Cyb3rn0id/Pellet-Stove-Web-Control/documents/schematic.jpg

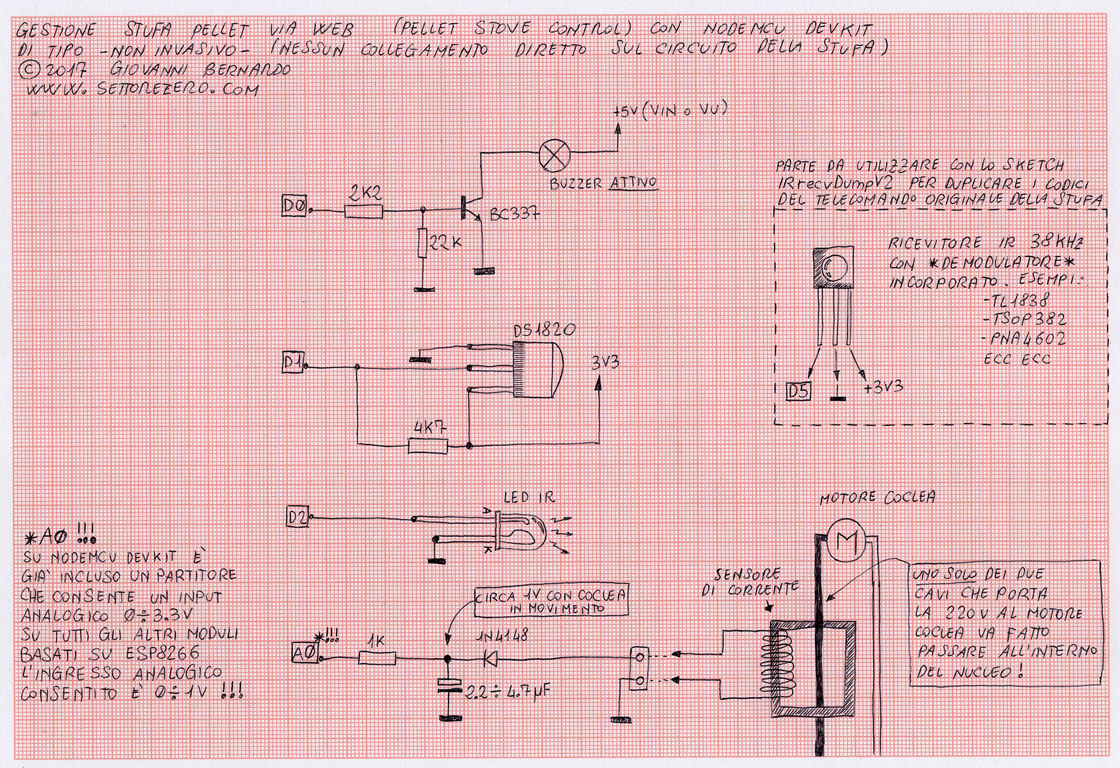
documents/schematic.jpg
