Cyb3rn0id/Pellet-Stove-Web-Control/images/current_sensor_1.jpg

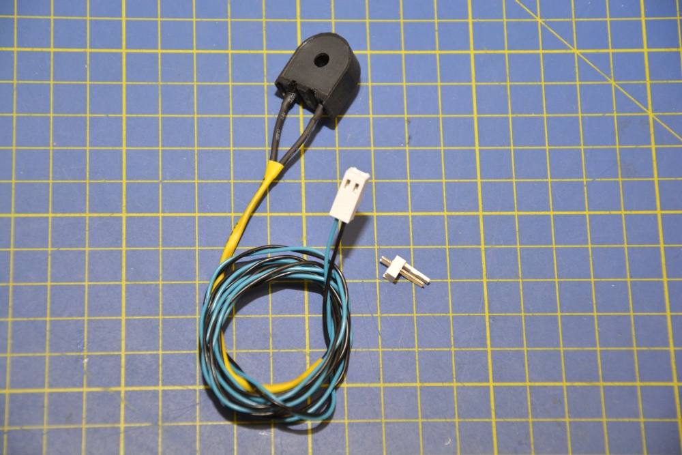
images/current_sensor_1.jpg
