Cyb3rn0id/Pellet-Stove-Web-Control/images/current_sensor_3.jpg

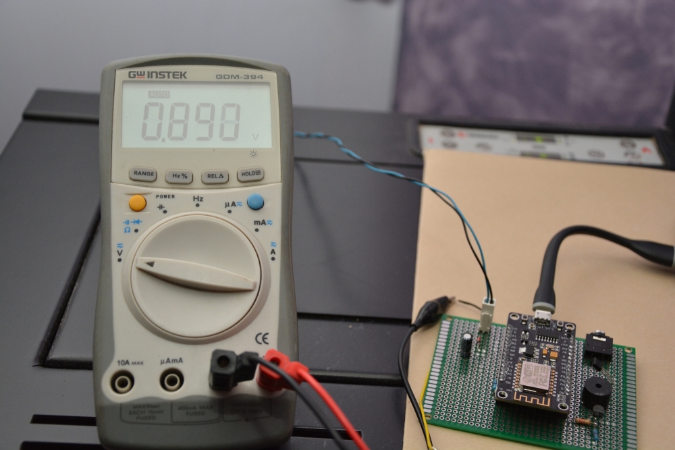
images/current_sensor_3.jpg
