Cyb3rn0id/Pellet-Stove-Web-Control/images/current_sensor_4.png

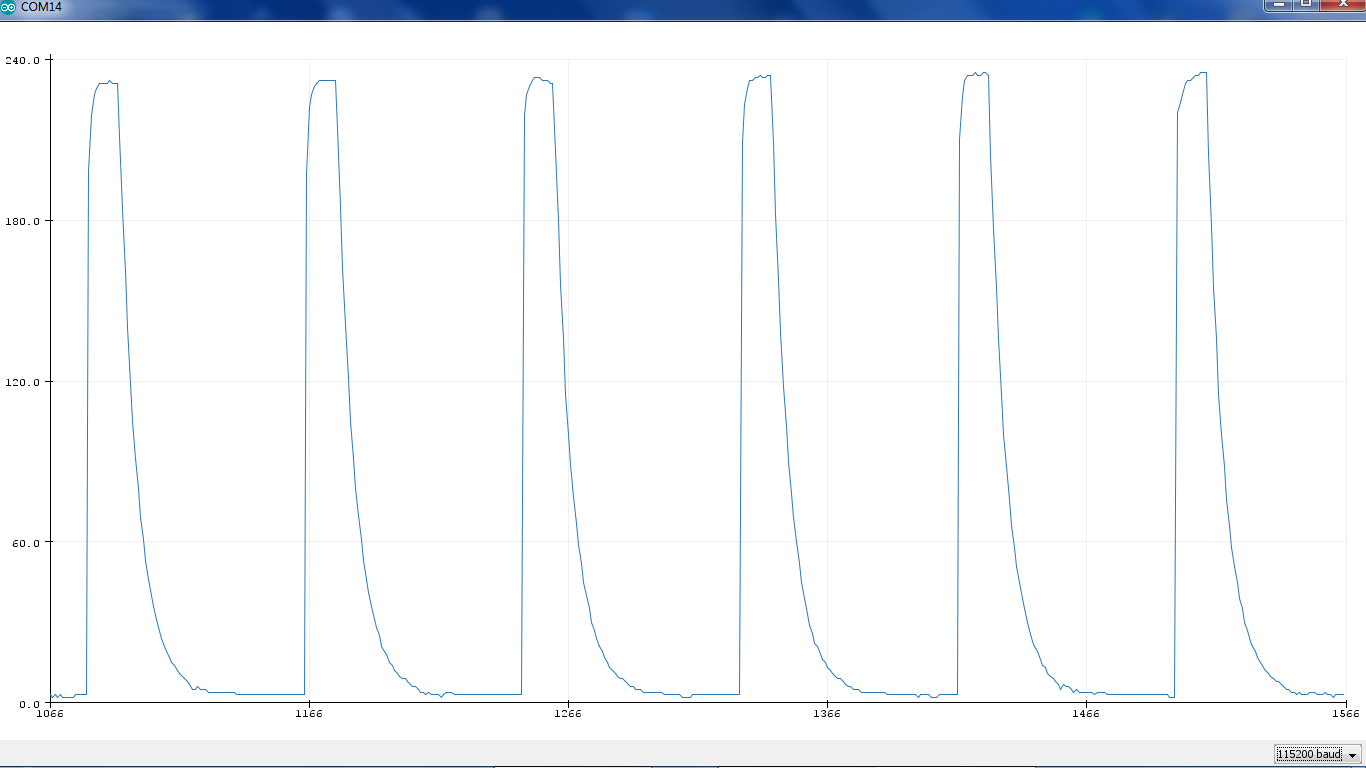
images/current_sensor_4.png
