Cyb3rn0id/Pellet-Stove-Web-Control/images/pic_01.jpg

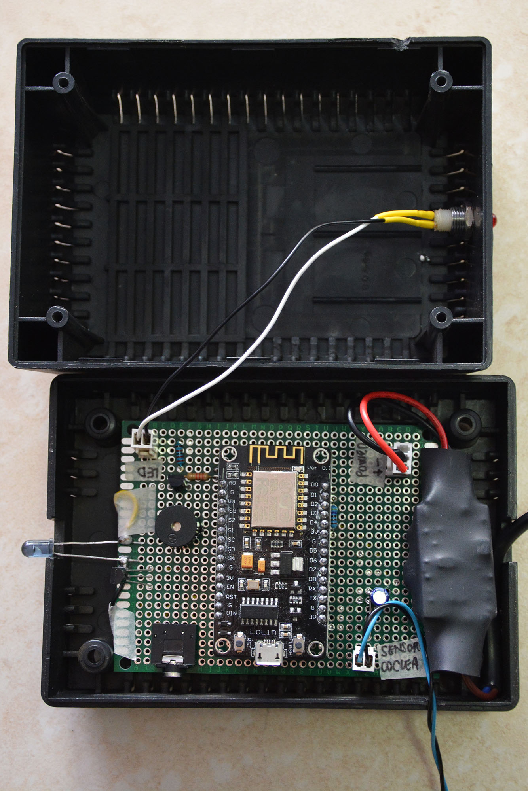
images/pic_01.jpg
