Cyb3rn0id/Pellet-Stove-Web-Control/images/pic_02.jpg

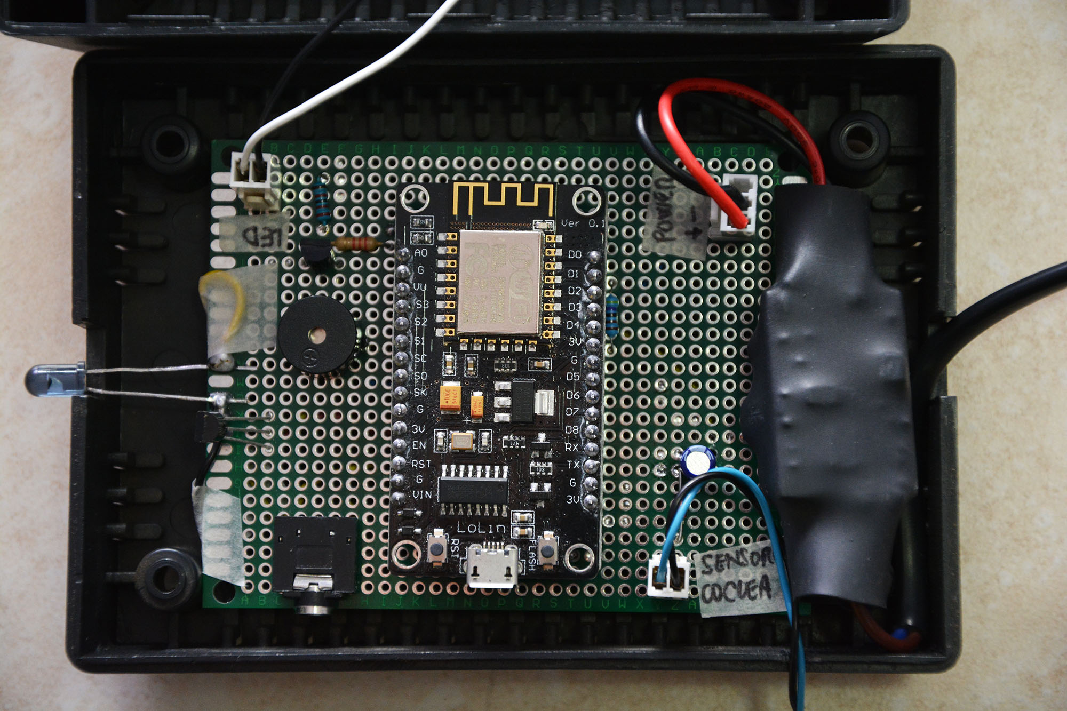
images/pic_02.jpg
