Cyb3rn0id/Pellet-Stove-Web-Control/images/pic_03.jpg

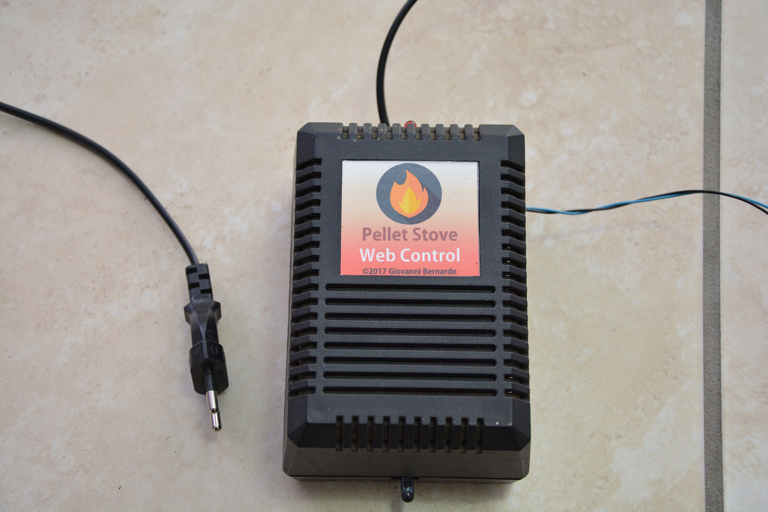
images/pic_03.jpg
