Cyb3rn0id/Pellet-Stove-Web-Control/images/pic_04.jpg

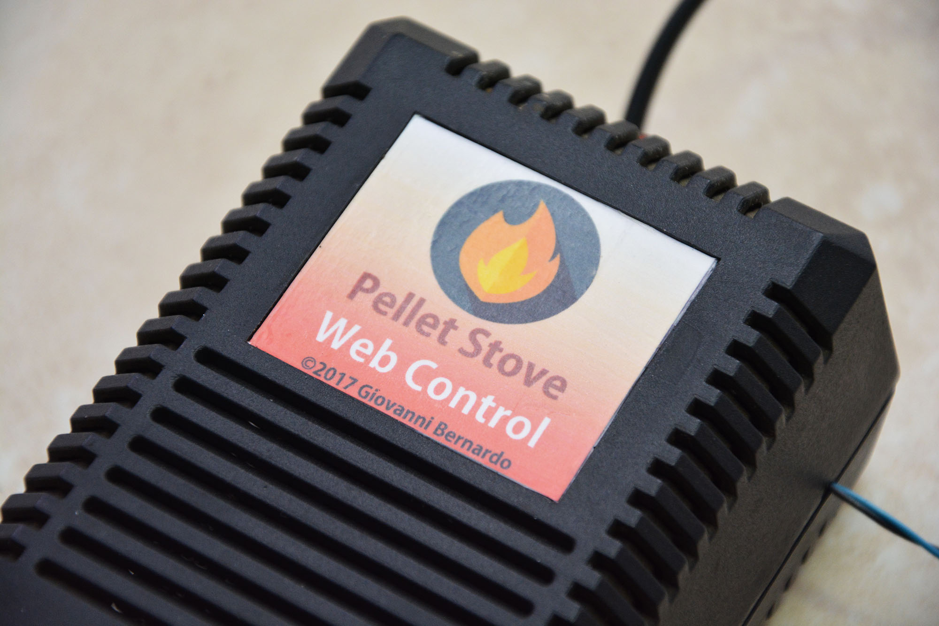
images/pic_04.jpg
