Cyb3rn0id/Pellet-Stove-Web-Control/images/pic_05.jpg

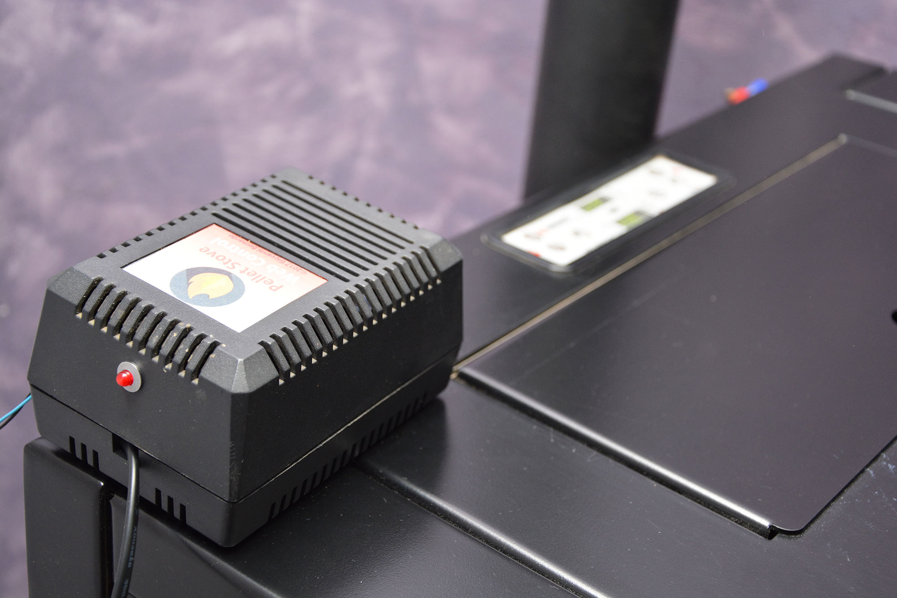
images/pic_05.jpg
