Cyb3rn0id/Pellet-Stove-Web-Control/images/pic_06.jpg

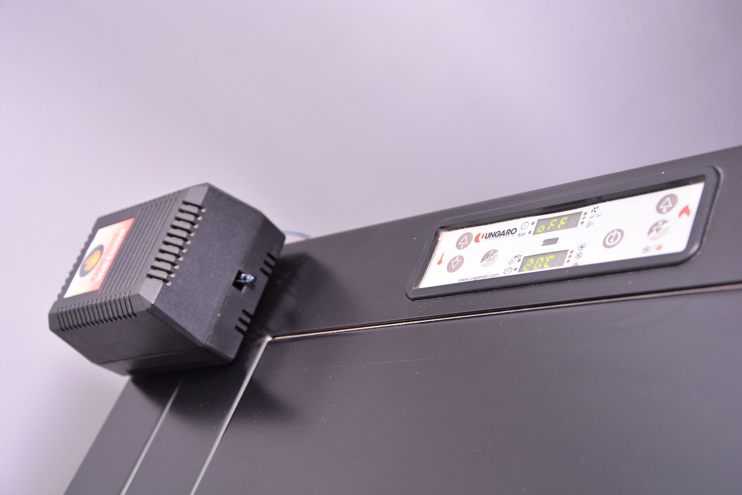
images/pic_06.jpg
