Cyb3rn0id/Pellet-Stove-Web-Control/images/pic_07.jpg

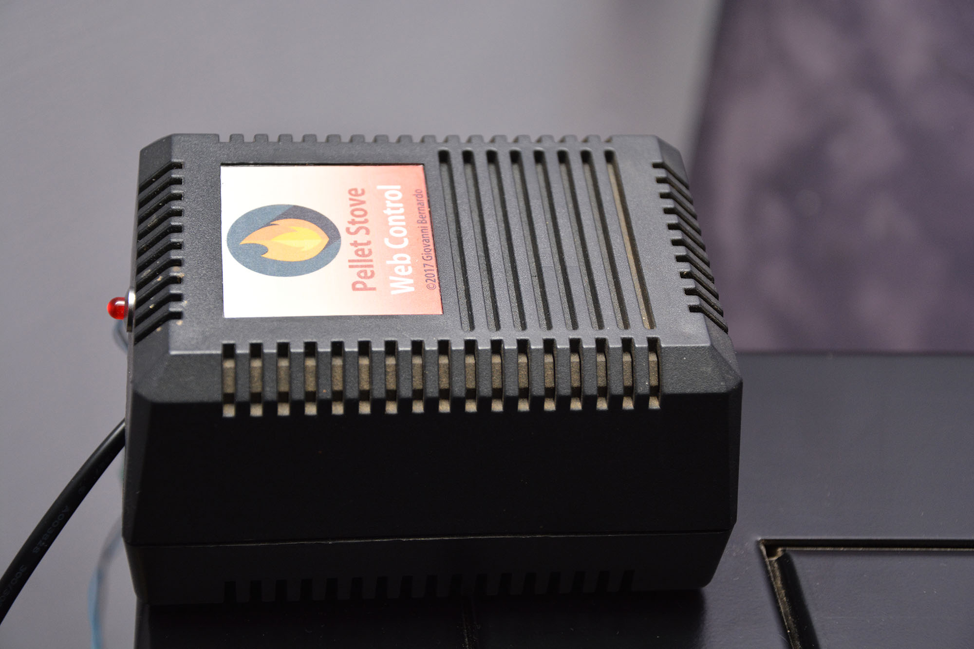
images/pic_07.jpg
