Cyb3rn0id/Pellet-Stove-Web-Control/images/pic_08.jpg

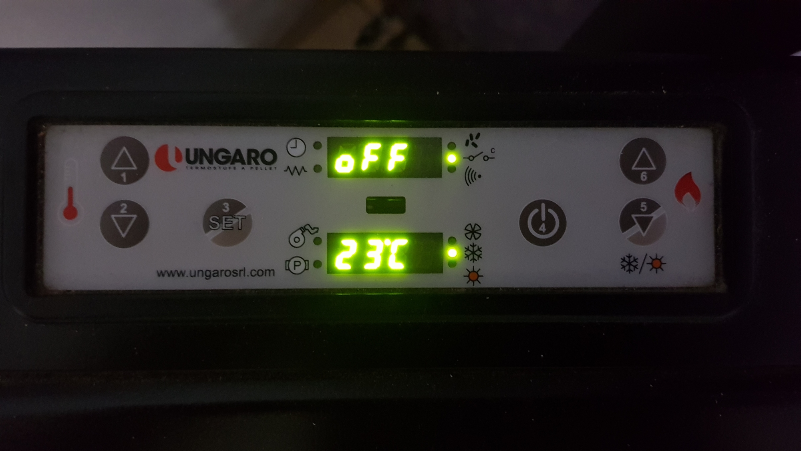
images/pic_08.jpg
