Cyb3rn0id/Pellet-Stove-Web-Control/images/remote.jpg

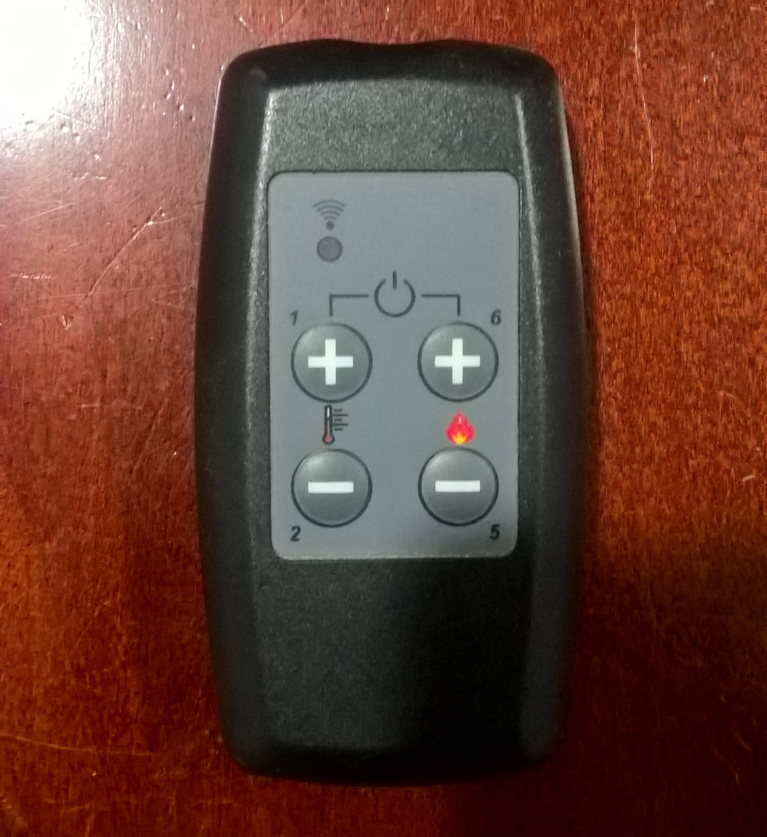
images/remote.jpg
