Cyb3rn0id/Pellet-Stove-Web-Control/images/webpage_1.png

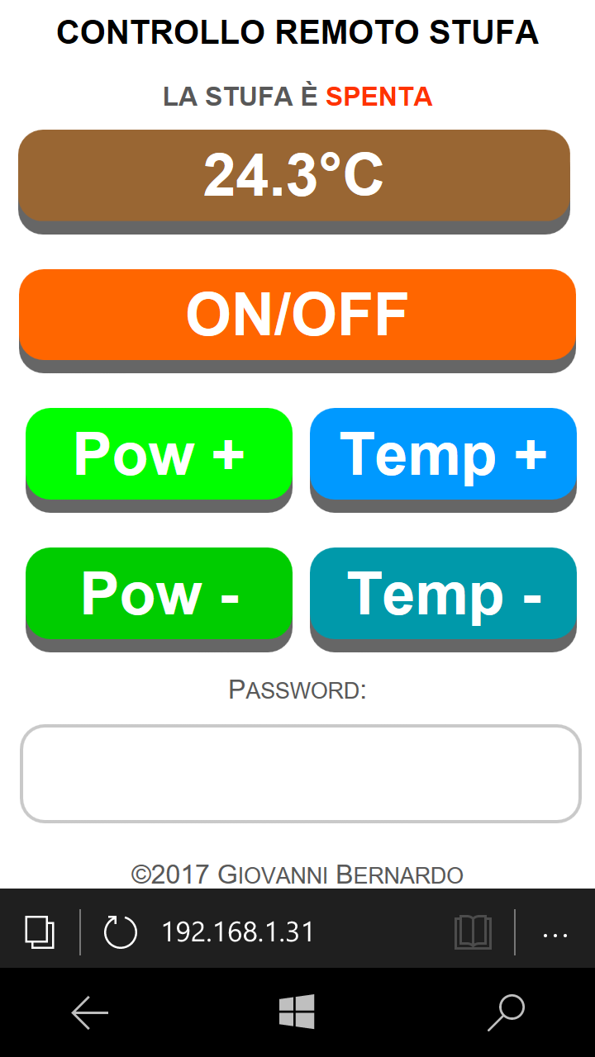
images/webpage_1.png
