Cyb3rn0id/Pellet-Stove-Web-Control/images/webpage_2.png

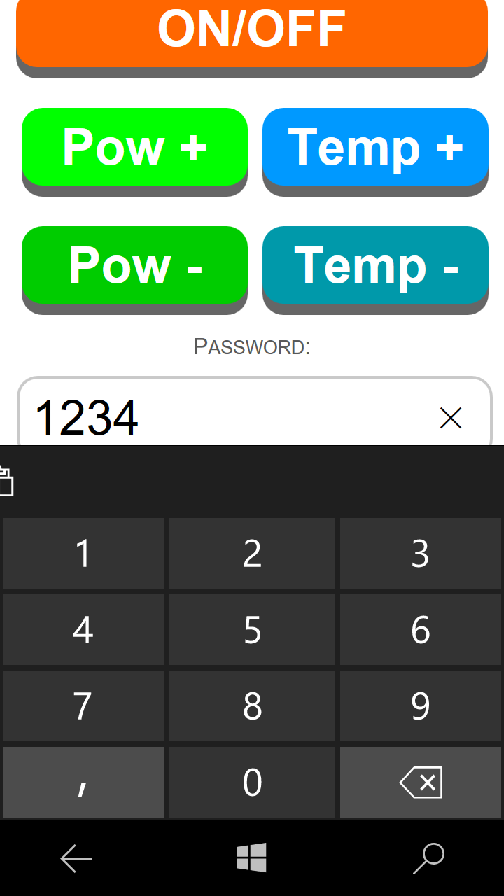
images/webpage_2.png
